CainPatel/petbot/(commit log)

2026-09-10 Bring in demo firmware, control UI, and demo video
    - firmware/uno_winches.cpp and esp32/esp32_claw.cpp from the PlatformIO
    project that ran the demo; WiFi credentials moved to gitignored secrets.h
    - platformio.ini with uno, esp32_usb and esp32 (OTA) envs
    - control.py: Flask page with live YOLO feed, moves, claw and delivery sequence
    - serial_link.py rewritten for the firmware's actual reply format
    - README replaced; docs updated for D11, floor-level winches, real anchors,
    v2 drum status; scaffold sketches moved to archive/
    - docs/media: cropped demo.mp4 and 8x GIF
    [cdpr_controller.ino, config.example.yaml, control.py, esp32_claw.cpp, mission.py, platform_node.ino, secrets.example.h]
2026-09-10 Polish README, add how-it-works guide, prices, and topics
    - README: centered header, badges, contents, platform photo slot, priced
    BOM (~$350 total), photo section; no em dashes
    - docs/how-it-works.md: the maths and software explained from the physical
    picture up, with a worked example on the real waypoints
    - docs/hardware.md prices converted to USD
    - em dashes removed across every doc and comment
2026-09-10 Add build guide; fix origin corner in calibration doc
2026-09-10 Say plainly the claw missed the treat; CAD on cainpatel.com; credit claw design
    - README, build log, build guide and CAD index now say the recorded run
    flew the full sequence with an empty claw
    - CAD files are hosted on cainpatel.com; placeholder folders removed
    - Claw design credited to the SG90 gripper on GrabCAD
    - Scaffold-era sketches removed from the repo
    - LICENSE holder is Cain Patel
    [cdpr_controller.ino, platform_node.ino]
2026-09-10 Require an OTA password; strip EXIF from the platform photo; security notes
    - ArduinoOTA.setPassword from the gitignored secrets.h; the matching
    --auth upload flag comes from a gitignored platformio.local.ini via
    extra_configs, with a tracked example of each
    - platform.jpg re-saved without EXIF (it carried device model and
    timestamp; no GPS), colour profile kept
    - README security notes: LAN-only, no login on the control page or the
    ESP32, never port-forward
2026-09-10 Point CAD downloads at the live petbot page on cainpatel.com
